movement-recognition/pouch2/lab/timings.md

## findings of 2024-12-01: debugging with gdb and "freertos"-addon
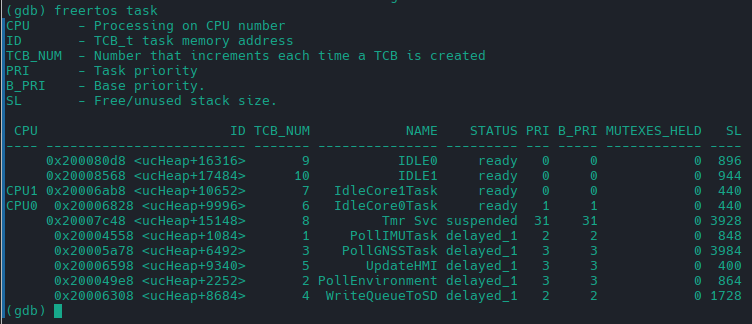
[picture p2: lab/asset/freertos_task_view.png]
Task view


## findings of 2024-11-21: debugging SD-SPI0:
SPI behaves weirdly with `pico_fatfs`-library.
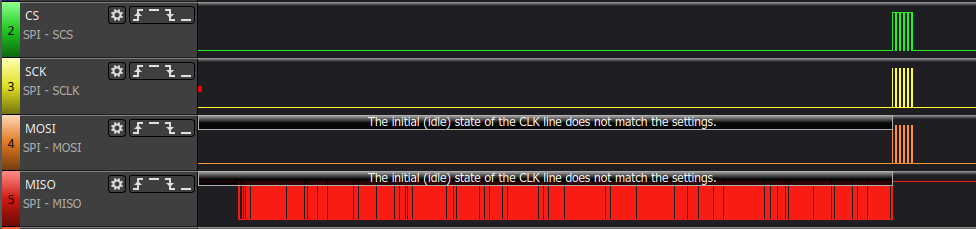
[picture p3: lab/asset/spi_weird_behaviour.png]
weird behaviour


=> solved by resoldering

## findings of 2024-11-13
- 10kHz freeRTOS Tick frequency
- 400kHz I²C
#### poll_imu_sensor()

- 534us @ 10kHz tick frequency
- 528us @ 1kHz tick frequency

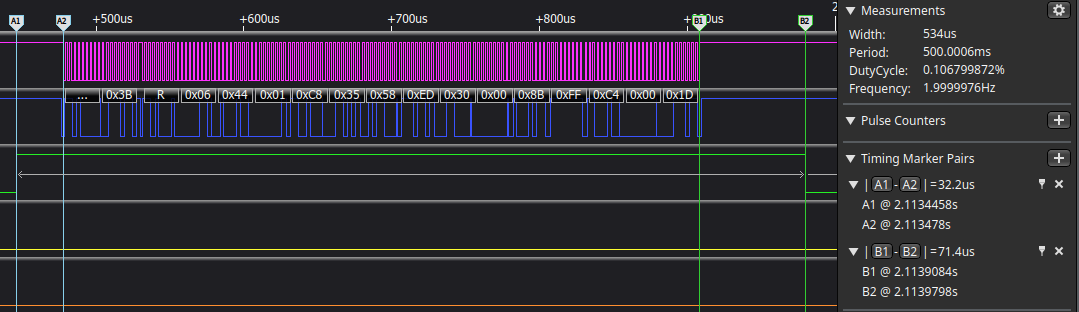
[picture p4: lab/asset/timing_poll_imu_sensor_raw.png]

- channel 0/1 (pink, blue)= I²C bus
- channel 2 (green) = GPIO 22

#### poll_env_sensor()
- 8.6ms @ 10kHz tick frequency
- 3.0ms @ 1kHz tick frequency
I²C-part takes the smallest amount of time, calculations afterwards take multiple milliseconds (!)
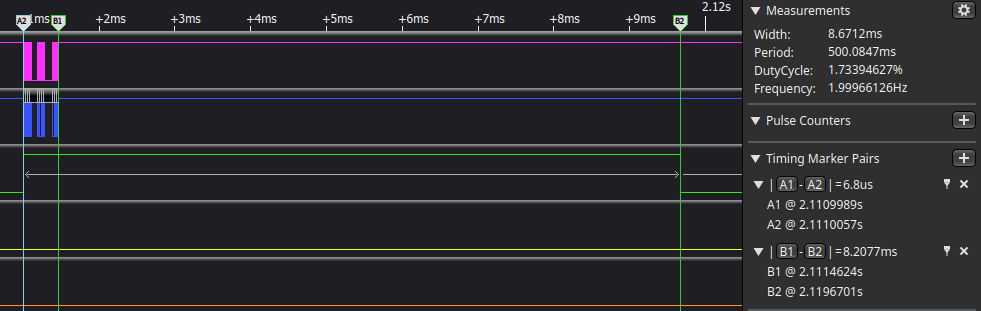
[picture p5: lab/asset/timing_poll_env_sensor_raw.png]

- channel 0/1 (pink, blue)= I²C bus
- channel 2 (green) = GPIO 22
