movement-recognition/pouch2/pcb/assets/pi3_gpio_header.png

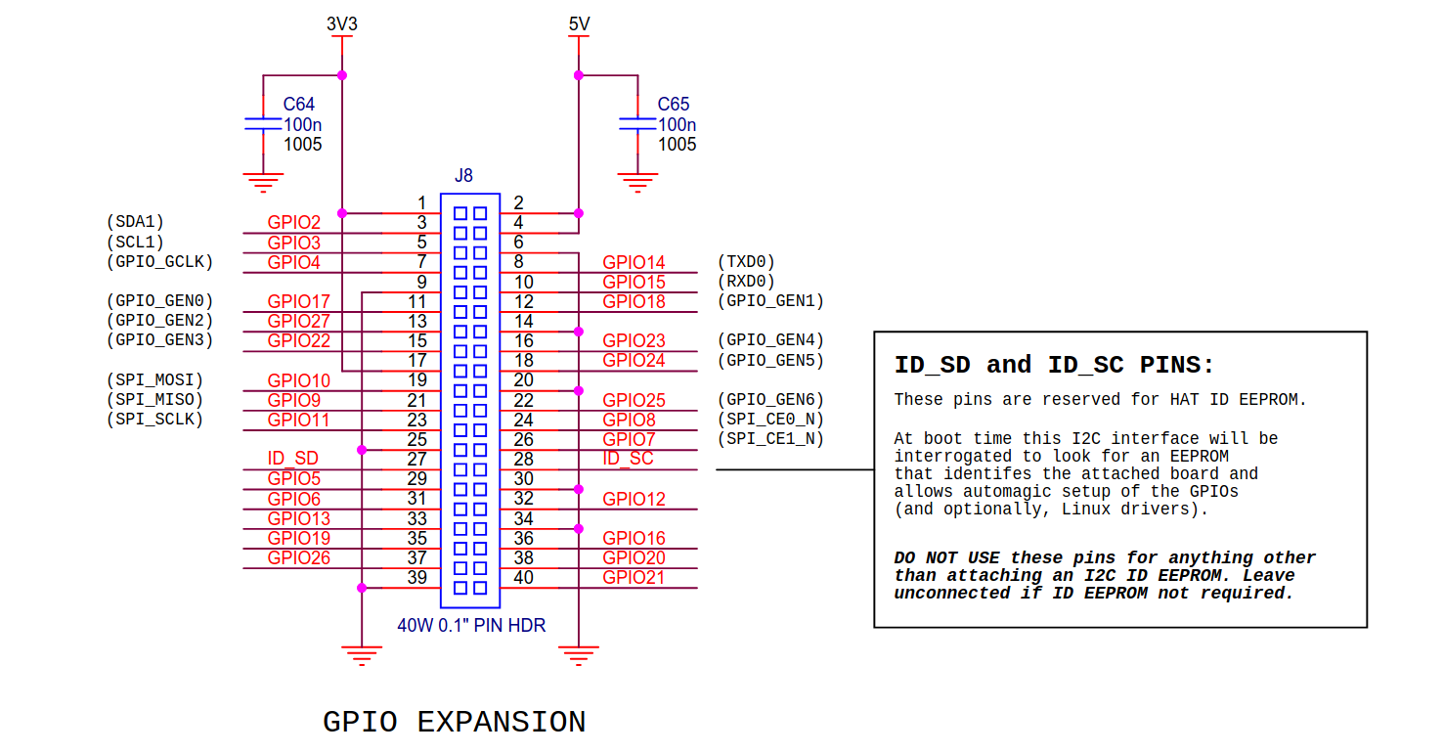
pcb/assets/pi3_gpio_header.png
