movement-recognition/pouch2/pcb/assets/picow-pinout.png

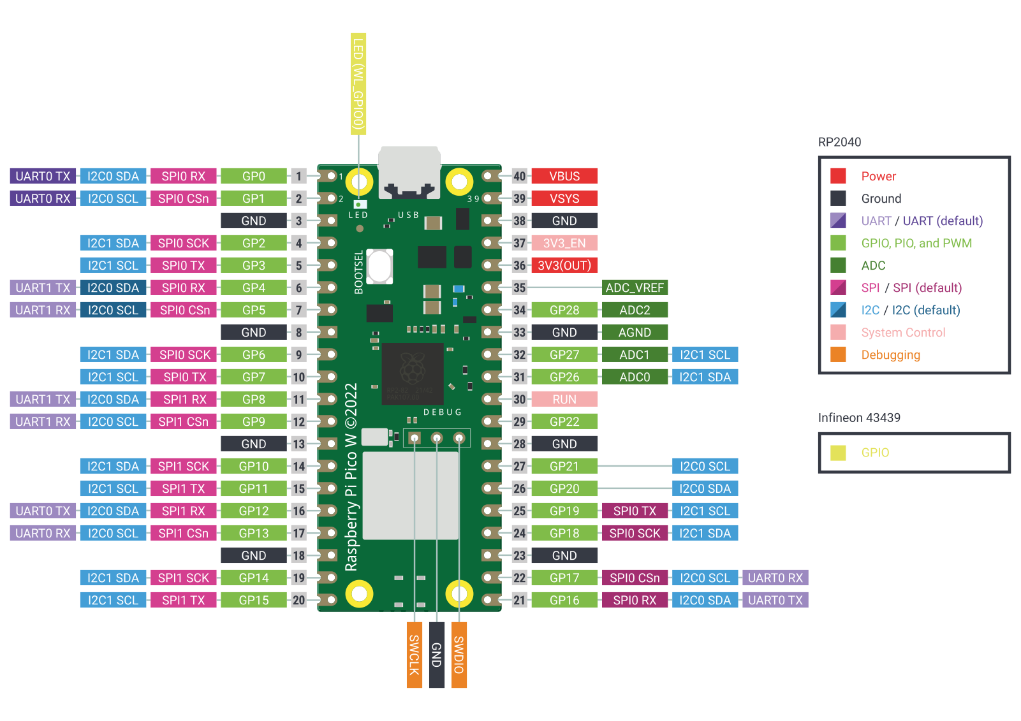
pcb/assets/picow-pinout.png
