movement-recognition/pouch2/pcb/pouch2.kicad_pcb

## KiCad design pcb/pouch2.kicad_pcb (2024-11-26)

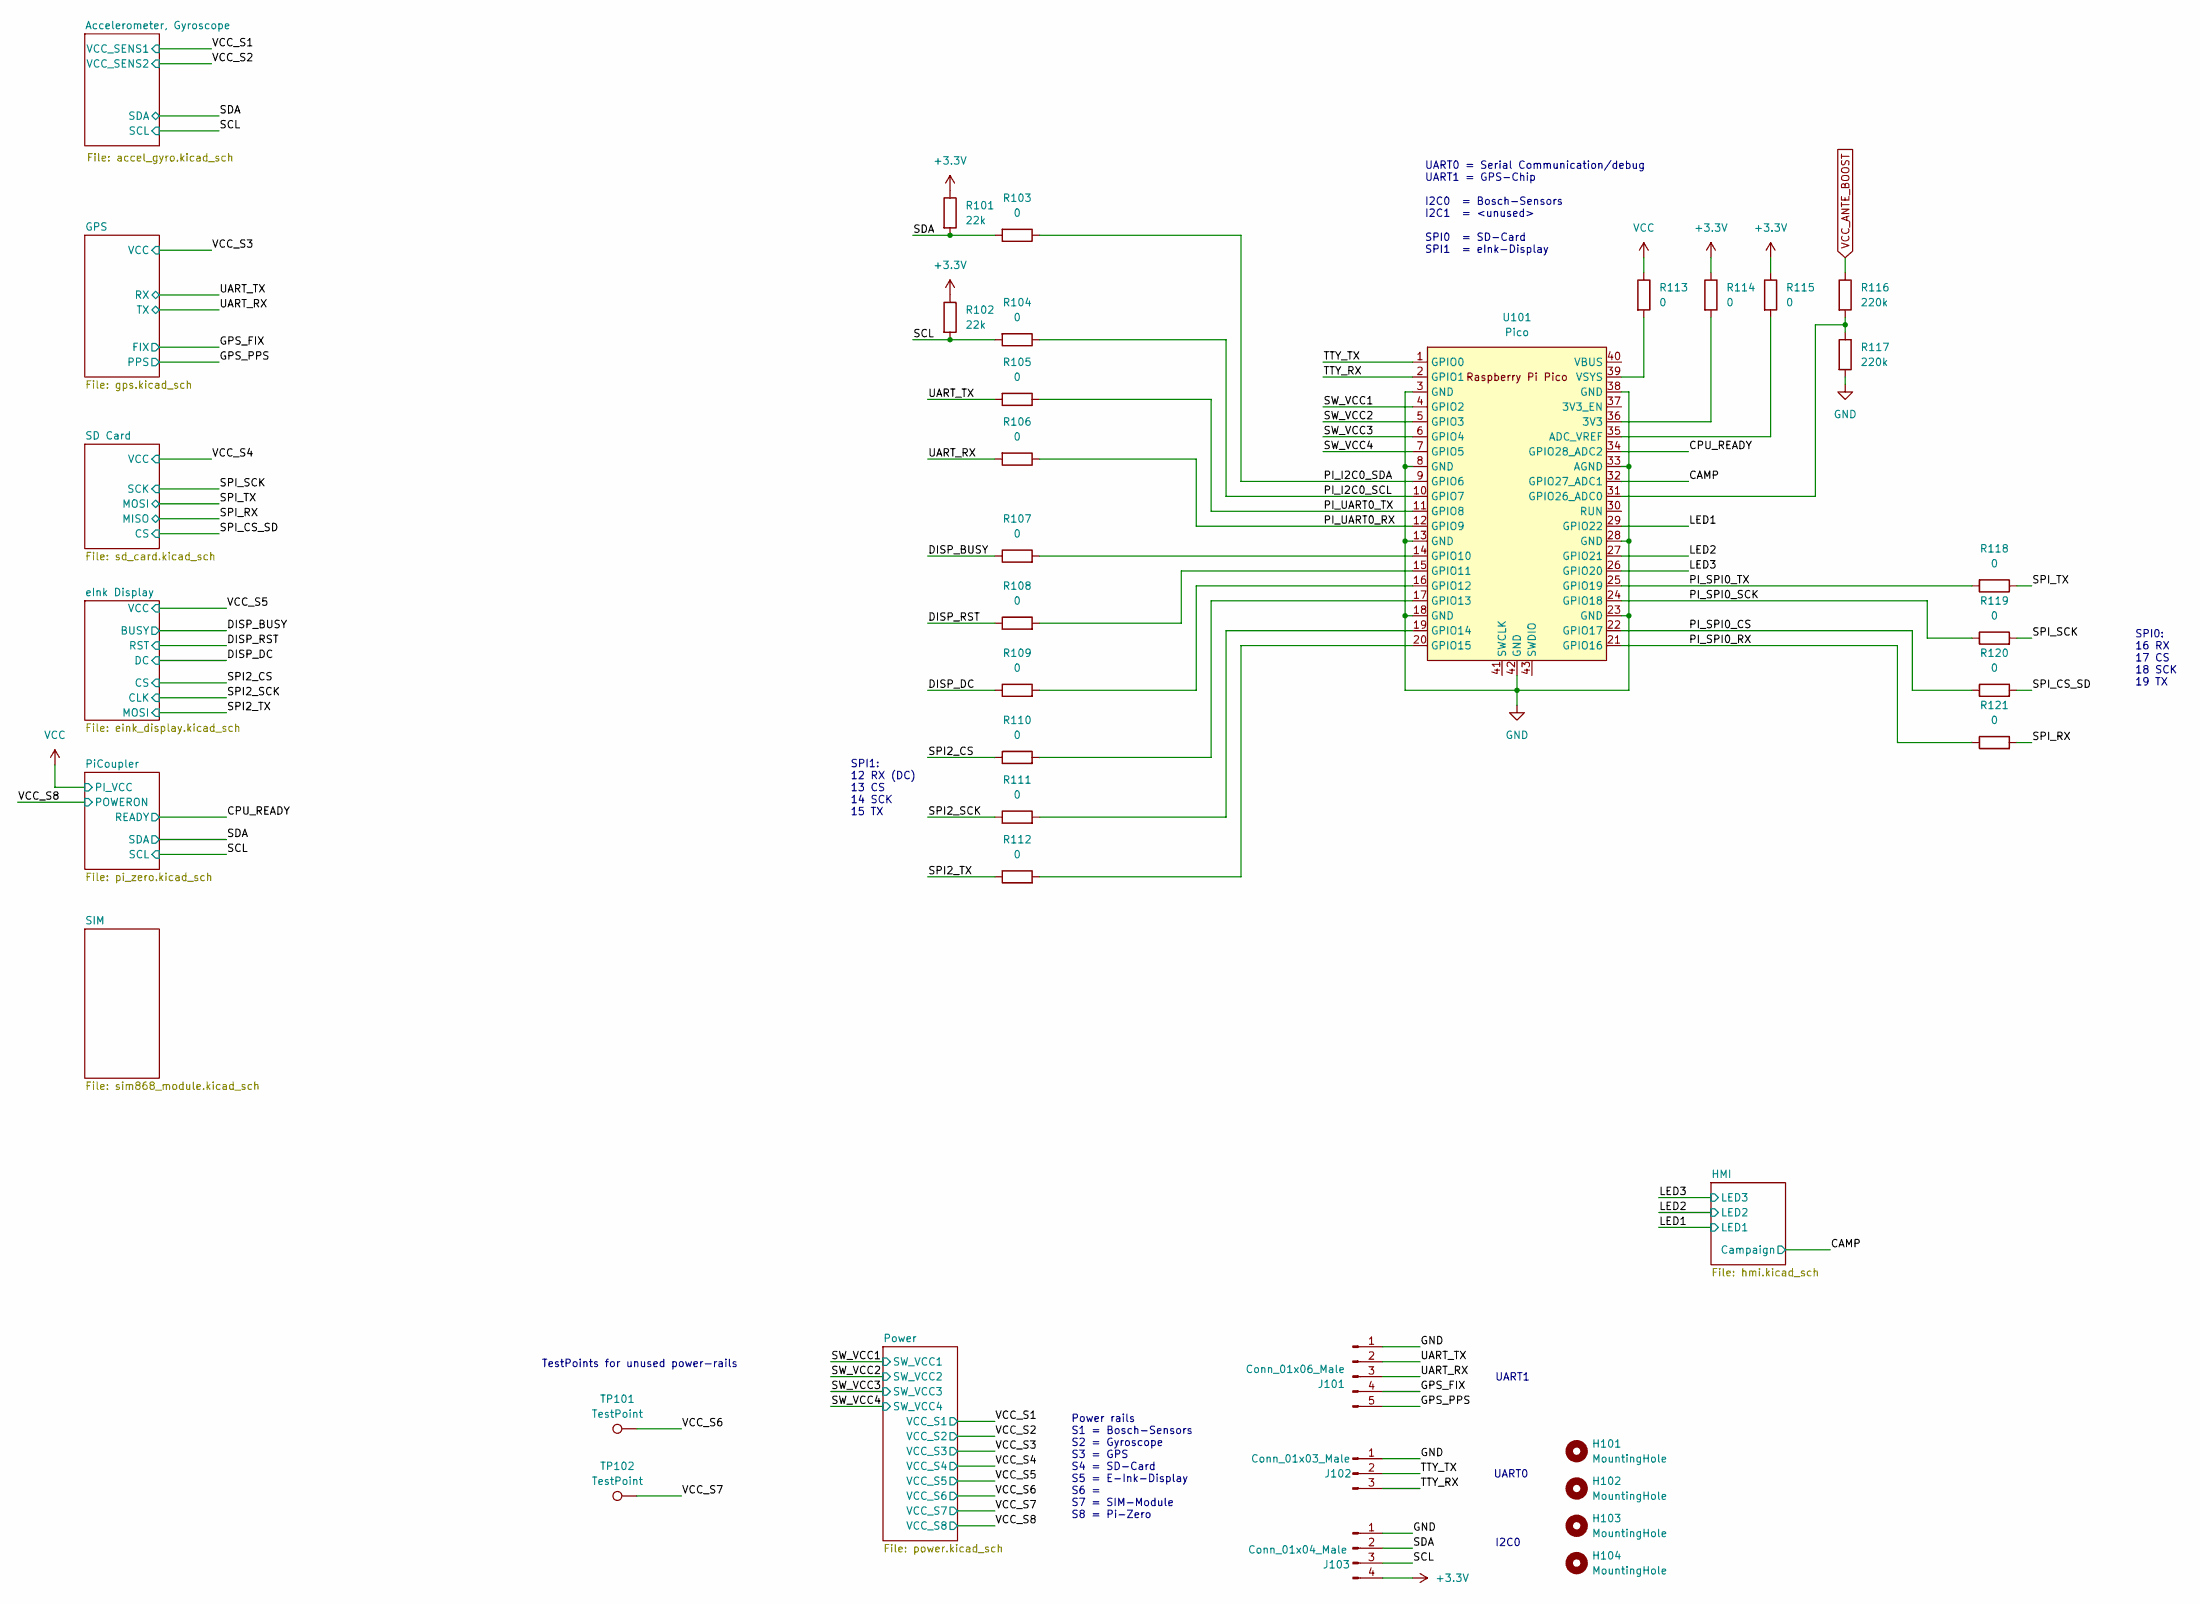
[picture p8: schematic pouch2.kicad_sch, Pouch 2]

Parts:
H101, H102, H103, H104: MountingHole; MountingHole_3.2mm_M3_DIN965_Pad_TopBottom
J101: Conn_01x06_Male; PinHeader_1x05_P2.54mm_Vertical
J102: Conn_01x03_Male; PinHeader_1x03_P2.54mm_Vertical
J103: Conn_01x04_Male; PinHeader_1x04_P2.54mm_Vertical
R101, R102: 22k; R_0805_2012Metric; MPN_Eurocircuit GPR080522K; LCSC C17560
R103, R104, R105, R106, R107, R108, R109, R110, R111, R112, R113, R114, R115, R118, R119, R120, R121: 0; R_0805_2012Metric; MPN_Eurocircuit GPR08050R; LCSC C17477
R116, R117: 220k; R_0805_2012Metric; MPN_Eurocircuit GPR0805220K; LCSC C17556
TP101, TP102: TestPoint; TestPoint_Pad_1.0x1.0mm
U101: Pico; RPi_Pico_SMD_TH

Connections:
+3.3V: J103.4, R101.1, R102.1, R114.1, R115.1; also elsewhere on the board
/CAMP: U101.32 (GPIO27_ADC1); also elsewhere on the board
/CPU_READY: U101.34 (GPIO28_ADC2); also elsewhere on the board
/DISP_BUSY: R107.1; also elsewhere on the board
/DISP_DC: R109.1; also elsewhere on the board
/DISP_RST: R108.1; also elsewhere on the board
/GPS_FIX: J101.4; also elsewhere on the board
/GPS_PPS: J101.5; also elsewhere on the board
/LED1: U101.29 (GPIO22); also elsewhere on the board
/LED2: U101.27 (GPIO21); also elsewhere on the board
/LED3: U101.26 (GPIO20); also elsewhere on the board
/PI_I2C0_SCL: R104.1, U101.10 (GPIO7)
/PI_I2C0_SDA: R103.1, U101.9 (GPIO6)
/PI_SPI0_CS: R120.1, U101.22 (GPIO17)
/PI_SPI0_RX: R121.1, U101.21 (GPIO16)
/PI_SPI0_SCK: R119.1, U101.24 (GPIO18)
/PI_SPI0_TX: R118.2, U101.25 (GPIO19)
/PI_UART0_RX: R106.1, U101.12 (GPIO9)
/PI_UART0_TX: R105.1, U101.11 (GPIO8)
/SCL: J103.3, R102.2, R104.2; also elsewhere on the board
/SDA: J103.2, R101.2, R103.2; also elsewhere on the board
/SPI2_CS: R110.1; also elsewhere on the board
/SPI2_SCK: R111.1; also elsewhere on the board
/SPI2_TX: R112.1; also elsewhere on the board
/SPI_CS_SD: R120.2; also elsewhere on the board
/SPI_RX: R121.2; also elsewhere on the board
/SPI_SCK: R119.2; also elsewhere on the board
/SPI_TX: R118.1; also elsewhere on the board
/SW_VCC1: U101.4 (GPIO2); also elsewhere on the board
/SW_VCC2: U101.5 (GPIO3); also elsewhere on the board
/SW_VCC3: U101.6 (GPIO4); also elsewhere on the board
/SW_VCC4: U101.7 (GPIO5); also elsewhere on the board
/TTY_RX: J102.3, U101.2 (GPIO1)
/TTY_TX: J102.2, U101.1 (GPIO0)
/UART_RX: J101.3, R106.2; also elsewhere on the board
/UART_TX: J101.2, R105.2; also elsewhere on the board
/VCC_S6: TP101.1; also elsewhere on the board
/VCC_S7: TP102.1; also elsewhere on the board
GND: J101.1, J102.1, J103.1, R117.2, U101.3 (GND), U101.8 (GND), U101.13 (GND), U101.18 (GND), U101.23 (GND), U101.28 (GND), U101.33 (AGND), U101.38 (GND), U101.42 (GND); also elsewhere on the board
unnamed: R114.2, U101.36 (3V3)
unnamed: R115.2, U101.35 (ADC_VREF)
unnamed: R107.2, U101.14 (GPIO10)
unnamed: R108.2, U101.15 (GPIO11)
unnamed: R109.2, U101.16 (GPIO12)
unnamed: R110.2, U101.17 (GPIO13)
unnamed: R111.2, U101.19 (GPIO14)
unnamed: R112.2, U101.20 (GPIO15)
unnamed: R116.2, R117.1, U101.31 (GPIO26_ADC0)
unnamed: R113.2, U101.39 (VSYS)
VCC: R113.1; also elsewhere on the board
VCC_ANTE_BOOST: R116.1; also elsewhere on the board

Notes on the sheet:
UART1
Power rails S1 = Bosch-Sensors S2 = Gyroscope S3 = GPS S4 = SD-Card S5 = E-Ink-Display S6 = S7 = SIM-Module S8 = Pi-Zero
UART0
SPI0: 16 RX 17 CS 18 SCK 19 TX
TestPoints for unused power-rails
SPI1: 12 RX (DC) 13 CS 14 SCK 15 TX
I2C0
UART0 = Serial Communication/debug UART1 = GPS-Chip I2C0 = Bosch-Sensors I2C1 = <unused> SPI0 = SD-Card SPI1 = eInk-Display

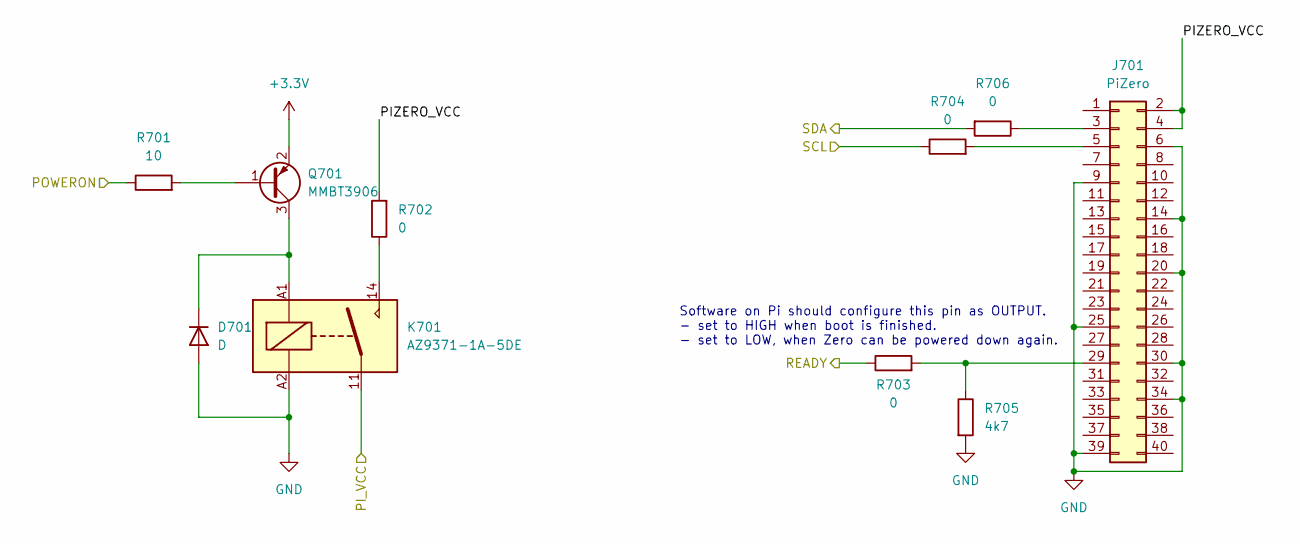
[picture p9: schematic pi_zero.kicad_sch, Pouch 2]

Parts:
D701: D; D_0805_2012Metric
J701: PiZero; Raspberry_Pi_Zero_Socket_wo_drills
K701: AZ9371-1A-5DE; Relay_1-Form-A_Schrack-RYII_RM5mm
Q701: MMBT3906; SOT-23; MPN_Eurocircuit MMBT3906
R701: 10; R_0805_2012Metric; MPN_Eurocircuit GPR080510R; LCSC C17415
R702, R703, R704, R706: 0; R_0805_2012Metric; MPN_Eurocircuit GPR08050R; LCSC C17477
R705: 4k7; R_0805_2012Metric; MPN_Eurocircuit GPR08054K7; LCSC C17673

Connections:
+3.3V: Q701.2 (E); also elsewhere on the board
/CPU_READY: R703.1; also elsewhere on the board
/PiCoupler/PIZERO_VCC: J701.2, J701.4, R702.2
/SCL: R704.1; also elsewhere on the board
/SDA: R706.2; also elsewhere on the board
/VCC_S8: R701.1; also elsewhere on the board
GND: D701.2 (A), J701.6, J701.9, J701.14, J701.20, J701.25, J701.30, J701.34, J701.39, K701.A2, R705.2; also elsewhere on the board
unnamed: D701.1 (K), K701.A1, Q701.3 (C)
unnamed: J701.3, R706.1
unnamed: J701.5, R704.2
unnamed: J701.29, R703.2, R705.1
unnamed: K701.14, R702.1
unnamed: Q701.1 (B), R701.2
VCC: K701.11; also elsewhere on the board

Notes on the sheet:
Software on Pi should configure this pin as OUTPUT. - set to HIGH when boot is finished. - set to LOW, when Zero can be powered down again.

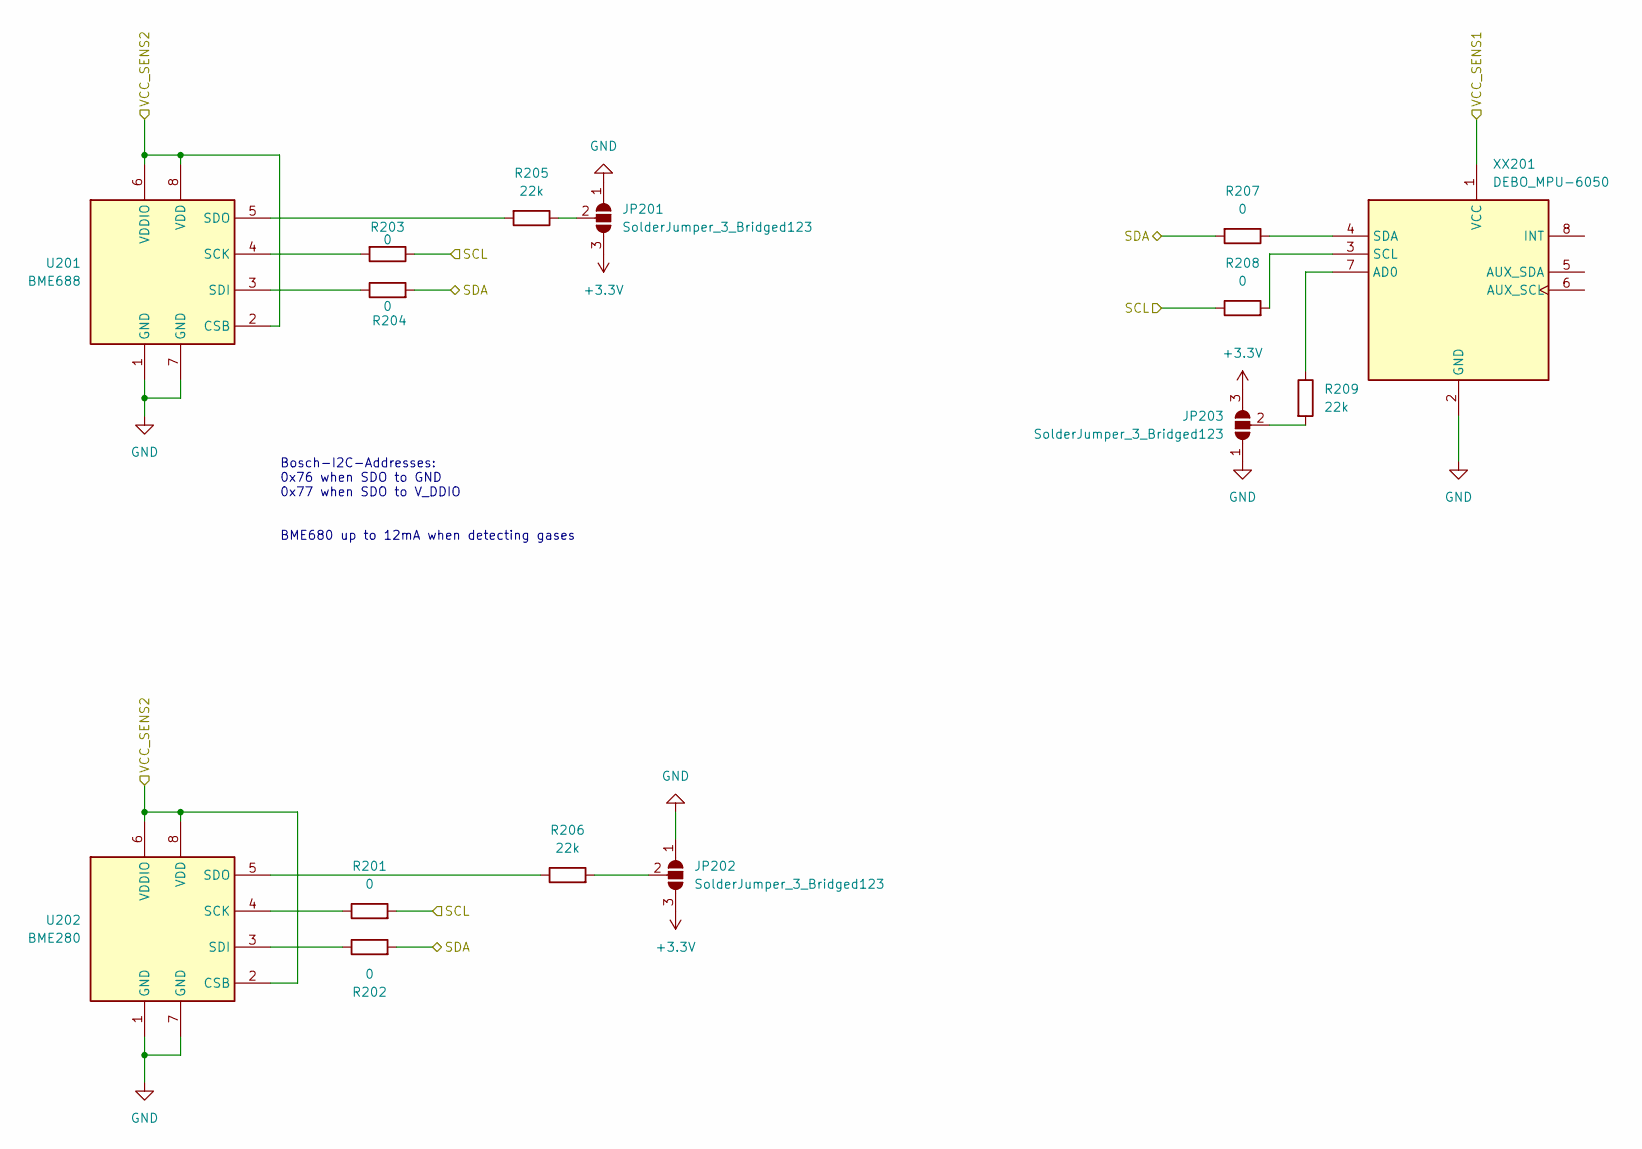
[picture p10: schematic accel_gyro.kicad_sch, Pouch 2]

Parts:
JP201, JP202, JP203: SolderJumper_3_Bridged123; SolderJumper-3_P2.0mm_Open_TrianglePad1.0x1.5mm_NumberLabels
R201, R202, R203, R204, R207, R208: 0; R_0805_2012Metric; MPN_Eurocircuit GPR08050R; LCSC C17477
R205, R206, R209: 22k; R_0805_2012Metric; MPN_Eurocircuit GPR080522K; LCSC C17560
U201: BME688; Bosch_LGA-8_3x3mm_P0.8mm_ClockwisePinNumbering
U202: BME280; Bosch_LGA-8_2.5x2.5mm_P0.65mm_ClockwisePinNumbering
XX201: DEBO_MPU-6050; DEBO_MPU6050

Connections:
+3.3V: JP201.3 (B), JP202.3 (B), JP203.3 (B); also elsewhere on the board
/SCL: R201.2, R203.1, R208.1; also elsewhere on the board
/SDA: R202.2, R204.2, R207.2; also elsewhere on the board
/VCC_S1: XX201.1 (VCC); also elsewhere on the board
/VCC_S2: U201.2 (CSB), U201.6 (VDDIO), U201.8 (VDD), U202.2 (CSB), U202.6 (VDDIO), U202.8 (VDD); also elsewhere on the board
GND: JP201.1 (A), JP202.1 (A), JP203.1 (A), U201.1 (GND), U201.7 (GND), U202.1 (GND), U202.7 (GND), XX201.2 (GND); also elsewhere on the board
unnamed: JP201.2 (C), R205.1
unnamed: JP202.2 (C), R206.2
unnamed: JP203.2 (C), R209.2
unnamed: R203.2, U201.4 (SCK)
unnamed: R204.1, U201.3 (SDI)
unnamed: R205.2, U201.5 (SDO)
unnamed: R201.1, U202.4 (SCK)
unnamed: R202.1, U202.3 (SDI)
unnamed: R206.1, U202.5 (SDO)
unnamed: R209.1, XX201.7 (AD0)
unnamed: R208.2, XX201.3 (SCL)
unnamed: R207.1, XX201.4 (SDA)

Notes on the sheet:
Bosch-I2C-Addresses: 0x76 when SDO to GND 0x77 when SDO to V_DDIO BME680 up to 12mA when detecting gases

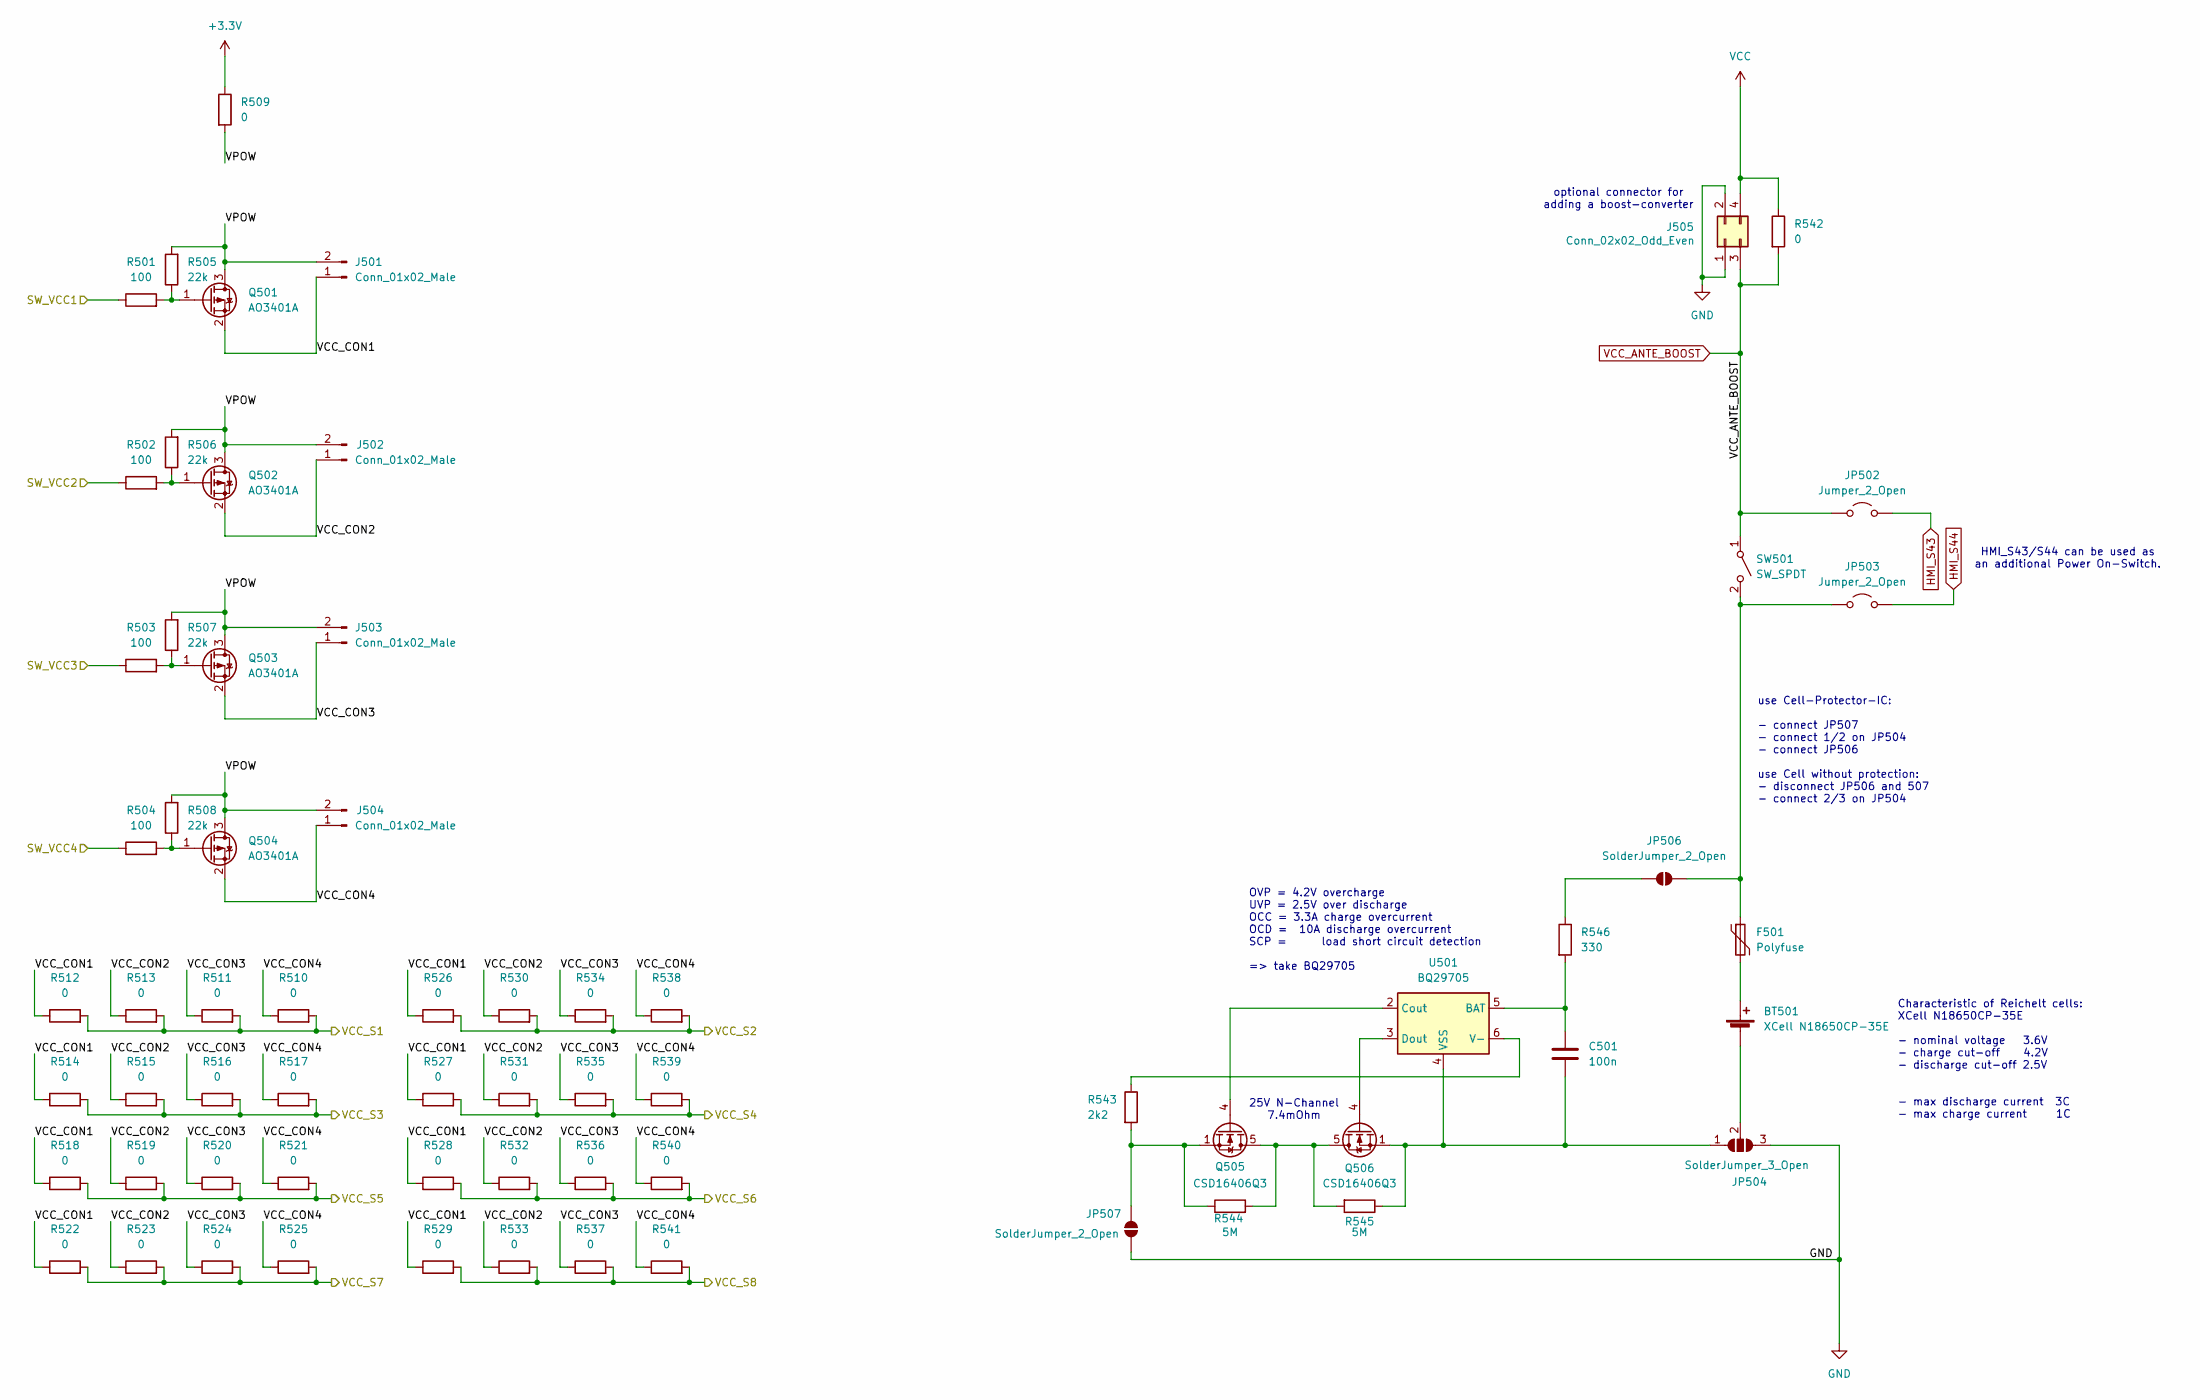
[picture p11: schematic power.kicad_sch, Pouch 2]

Parts:
BT501: XCell N18650CP-35E; 18650_Keystone_1043
C501: 100n; C_0805_2012Metric; MPN_Eurocircuit GPC0805104
F501: Polyfuse; Fuse_BelFuse_0ZRE0005FF_L8.3mm_W3.8mm
J501, J502, J503, J504: Conn_01x02_Male; PinHeader_1x02_P2.54mm_Vertical
J505: Conn_02x02_Odd_Even; PinHeader_1x04_P2.54mm_Vertical
JP502, JP503: Jumper_2_Open; SolderJumper-2_P1.3mm_Open_TrianglePad1.0x1.5mm
JP504: SolderJumper_3_Open; SolderJumper-3_P2.0mm_Open_TrianglePad1.0x1.5mm_NumberLabels
JP506, JP507: SolderJumper_2_Open; SolderJumper-2_P1.3mm_Open_TrianglePad1.0x1.5mm
Q501, Q502, Q503, Q504: AO3401A; SOT-23; MPN_Eurocircuit AO3401A; LCSC C15127
Q505, Q506: CSD16406Q3; VSON-8-1EP_3x3mm_P0.65mm_EP1.65x2.4mm; MPN_Eurocircuit CSD16406Q3
R501, R502, R503, R504: 100; R_0805_2012Metric; MPN_Eurocircuit GPR0805100R; LCSC C17408
R505, R506, R507, R508: 22k; R_0805_2012Metric; MPN_Eurocircuit GPR080522K; LCSC C17560
R509, R510, R511, R512, R513, R514, R515, R516, R517, R518, R519, R520, R521, R522, R523, R524, R525, R526, R527, R528, R529, R530, R531, R532, R533, R534, R535, R536, R537, R538, R539, R540, R541, R542: 0; R_0805_2012Metric; MPN_Eurocircuit GPR08050R; LCSC C17477
R543: 2k2; R_0805_2012Metric; MPN_Eurocircuit GPR08052K2; LCSC C17520
R544, R545: 5M; R_0805_2012Metric; MPN_Eurocircuit GPR08055M1; LCSC C2933370
R546: 330; R_0805_2012Metric; MPN_Eurocircuit GPR0805330R; LCSC C17630
SW501: SW_SPDT; PinHeader_1x02_P2.54mm_Vertical
U501: BQ29705; WSON-6_1.5x1.5mm_P0.5mm; MPN_Eurocircuit BQ29705DSER

Connections:
+3.3V: R509.1; also elsewhere on the board
/Power/VCC_CON1: J501.1, Q501.2 (S), R512.1, R514.1, R518.1, R522.1, R526.1, R527.1, R528.1, R529.1
/Power/VCC_CON2: J502.1, Q502.2 (S), R513.1, R515.1, R519.1, R523.1, R530.1, R531.1, R532.1, R533.1
/Power/VCC_CON3: J503.1, Q503.2 (S), R511.1, R516.1, R520.1, R524.1, R534.1, R535.1, R536.1, R537.1
/Power/VCC_CON4: J504.1, Q504.2 (S), R510.1, R517.1, R521.1, R525.1, R538.1, R539.1, R540.1, R541.1
/Power/VPOW: J501.2, J502.2, J503.2, J504.2, Q501.3 (D), Q502.3 (D), Q503.3 (D), Q504.3 (D), R505.2, R506.2, R507.2, R508.2, R509.2
/SW_VCC1: R501.1; also elsewhere on the board
/SW_VCC2: R502.1; also elsewhere on the board
/SW_VCC3: R503.1; also elsewhere on the board
/SW_VCC4: R504.1; also elsewhere on the board
/VCC_S1: R510.2, R511.2, R512.2, R513.2; also elsewhere on the board
/VCC_S2: R526.2, R530.2, R534.2, R538.2; also elsewhere on the board
/VCC_S3: R514.2, R515.2, R516.2, R517.2; also elsewhere on the board
/VCC_S4: R527.2, R531.2, R535.2, R539.2; also elsewhere on the board
/VCC_S5: R518.2, R519.2, R520.2, R521.2; also elsewhere on the board
/VCC_S6: R528.2, R532.2, R536.2, R540.2; also elsewhere on the board
/VCC_S7: R522.2, R523.2, R524.2, R525.2; also elsewhere on the board
/VCC_S8: R529.2, R533.2, R537.2, R541.2; also elsewhere on the board
GND: J505.1, J505.2, JP504.3 (B), JP507.1 (A); also elsewhere on the board
HMI_S43: JP502.2 (B); also elsewhere on the board
HMI_S44: JP503.2 (B); also elsewhere on the board
unnamed: BT501.1 (+), F501.2
unnamed: BT501.2 (-), JP504.2 (C)
unnamed: F501.1, JP503.1 (A), JP506.1 (A), SW501.2 (B)
unnamed: C501.2, JP504.1 (A), Q506.1 (S), Q506.2 (S), Q506.3 (S), R545.1, U501.4 (VSS)
unnamed: JP506.2 (B), R546.1
unnamed: JP507.2 (B), Q505.1 (S), Q505.2 (S), Q505.3 (S), R543.2, R544.1
unnamed: Q501.1 (G), R501.2, R505.1
unnamed: Q502.1 (G), R502.2, R506.1
unnamed: Q503.1 (G), R503.2, R507.1
unnamed: Q504.1 (G), R504.2, R508.1
unnamed: Q505.5 (D), Q506.5 (D), R544.2, R545.2
unnamed: Q505.4 (G), U501.2 (Cout)
unnamed: Q506.4 (G), U501.3 (Dout)
unnamed: C501.1, R546.2, U501.5 (BAT)
unnamed: R543.1, U501.6 (V-)
VCC: J505.4, R542.1; also elsewhere on the board
VCC_ANTE_BOOST: J505.3, JP502.1 (A), R542.2, SW501.1 (A); also elsewhere on the board

Notes on the sheet:
25V N-Channel 7.4mOhm
HMI_S43/S44 can be used as an additional Power On-Switch.
OVP = 4.2V overcharge UVP = 2.5V over discharge OCC = 3.3A charge overcurrent OCD = 10A discharge overcurrent SCP = load short circuit detection => take BQ29705
use Cell-Protector-IC: - connect JP507 - connect 1/2 on JP504 - connect JP506 use Cell without protection: - disconnect JP506 and 507 - connect 2/3 on JP504
optional connector for adding a boost-converter
Characteristic of Reichelt cells: XCell N18650CP-35E - nominal voltage 3.6V - charge cut-off 4.2V - discharge cut-off 2.5V - max discharge current 3C - max charge current 1C

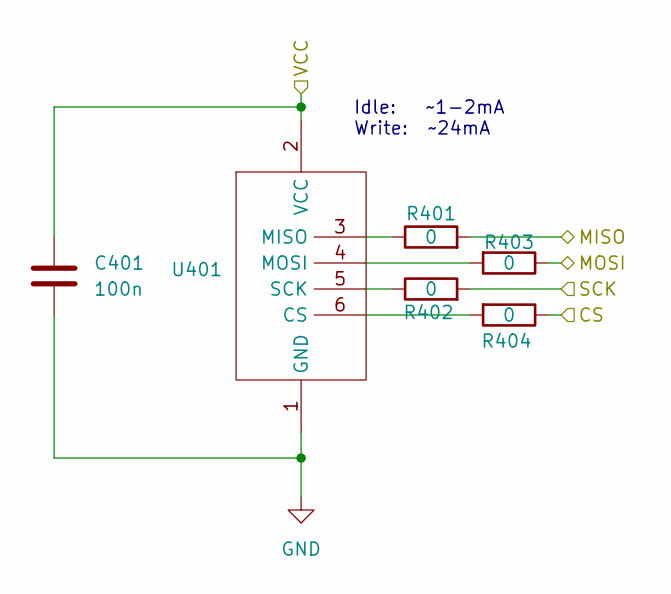
[picture p12: schematic sd_card.kicad_sch, Pouch 2]

Parts:
C401: 100n; C_0805_2012Metric
R401, R402, R403, R404: 0; R_0805_2012Metric; MPN_Eurocircuit GPR08050R; LCSC C17477
U401: DEBO_SD-Card

Connections:
/SPI_CS_SD: R404.1; also elsewhere on the board
/SPI_RX: R401.2; also elsewhere on the board
/SPI_SCK: R402.2; also elsewhere on the board
/SPI_TX: R403.1; also elsewhere on the board
/VCC_S4: C401.1, U401.2 (VCC); also elsewhere on the board
GND: C401.2, U401.1 (GND); also elsewhere on the board
unnamed: R404.2, U401.6 (CS)
unnamed: R401.1, U401.3 (MISO)
unnamed: R403.2, U401.4 (MOSI)
unnamed: R402.1, U401.5 (SCK)

Notes on the sheet:
Idle: ~1-2mA Write: ~24mA

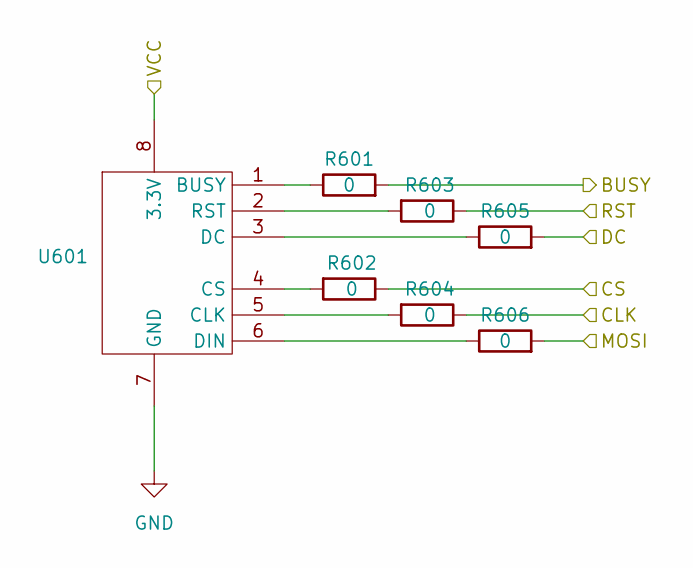
[picture p13: schematic eink_display.kicad_sch, Pouch 2]

Parts:
R601, R602, R603, R604, R605, R606: 0; R_0805_2012Metric; MPN_Eurocircuit GPR08050R; LCSC C17477
U601: PinHeader_1x08_P2.54mm_Vertical

Connections:
/DISP_BUSY: R601.2; also elsewhere on the board
/DISP_DC: R605.2; also elsewhere on the board
/DISP_RST: R603.1; also elsewhere on the board
/SPI2_CS: R602.1; also elsewhere on the board
/SPI2_SCK: R604.1; also elsewhere on the board
/SPI2_TX: R606.2; also elsewhere on the board
/VCC_S5: U601.8 (3.3V); also elsewhere on the board
GND: U601.7 (GND); also elsewhere on the board
unnamed: R601.1, U601.1 (BUSY)
unnamed: R604.2, U601.5 (CLK)
unnamed: R602.2, U601.4 (CS)
unnamed: R605.1, U601.3 (DC)
unnamed: R606.1, U601.6 (DIN)
unnamed: R603.2, U601.2 (RST)

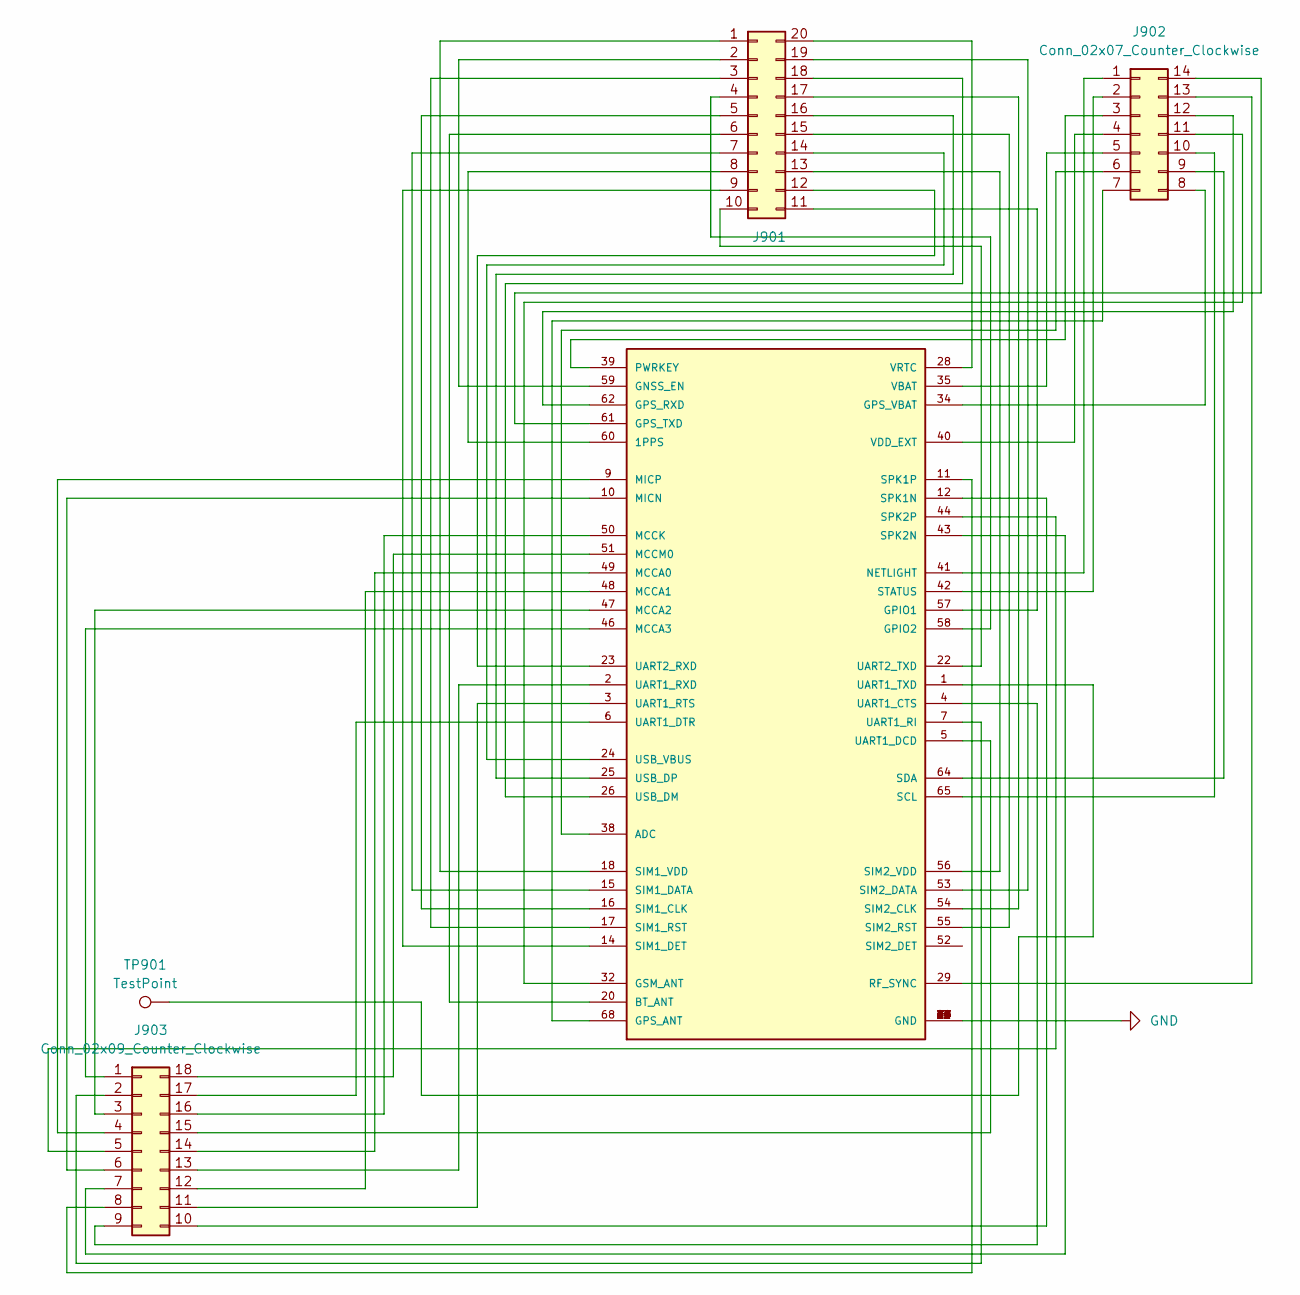
[picture p14: schematic sim868_module.kicad_sch, Pouch 2]

Parts:
J901: Conn_02x03_Counter_Clockwise; PinHeader_2x10_P1.00mm_Vertical_SMD
J902: Conn_02x07_Counter_Clockwise; PinHeader_2x07_P1.00mm_Vertical_SMD
J903: Conn_02x09_Counter_Clockwise; PinHeader_2x09_P1.00mm_Vertical_SMD
TP901: TestPoint; TestPoint_Pad_D1.0mm
U901: SIM868; XCVR_SIM868

Connections:
GND: U901.8 (GND), U901.13 (GND), U901.19 (GND), U901.21 (GND), U901.27 (GND), U901.30 (GND), U901.31 (GND), U901.33 (GND), U901.36 (GND), U901.37 (GND), U901.45 (GND), U901.63 (GND), U901.66 (GND), U901.67 (GND), U901.69 (GND), U901.70 (GND), U901.71 (GND), U901.72 (GND), U901.73 (GND), U901.74 (GND), U901.75 (GND), U901.76 (GND), U901.77 (GND); also elsewhere on the board
unnamed: J901.1, U901.18 (SIM1_VDD)
unnamed: J901.2, U901.59 (GNSS_EN)
unnamed: J901.3, U901.17 (SIM1_RST)
unnamed: J901.4, U901.58 (GPIO2)
unnamed: J901.5, U901.16 (SIM1_CLK)
unnamed: J901.6, U901.20 (BT_ANT)
unnamed: J901.7, U901.15 (SIM1_DATA)
unnamed: J901.8, U901.60 (1PPS)
unnamed: J901.9, U901.14 (SIM1_DET)
unnamed: J901.10, U901.22 (UART2_TXD)
unnamed: J901.11, U901.57 (GPIO1)
unnamed: J901.12, U901.23 (UART2_RXD)
unnamed: J901.13, U901.56 (SIM2_VDD)
unnamed: J901.14, U901.24 (USB_VBUS)
unnamed: J901.15, U901.55 (SIM2_RST)
unnamed: J901.16, U901.25 (USB_DP)
unnamed: J901.17, U901.54 (SIM2_CLK)
unnamed: J901.18, U901.26 (USB_DM)
unnamed: J901.19, U901.53 (SIM2_DATA)
unnamed: J901.20, U901.28 (VRTC)
unnamed: J902.1, U901.41 (NETLIGHT)
unnamed: J902.2, U901.42 (STATUS)
unnamed: J902.3, U901.39 (PWRKEY)
unnamed: J902.4, U901.40 (VDD_EXT)
unnamed: J902.5, U901.35 (VBAT)
unnamed: J902.6, U901.38 (ADC)
unnamed: J902.7, U901.68 (GPS_ANT)
unnamed: J902.8, U901.34 (GPS_VBAT)
unnamed: J902.9, U901.64 (SDA)
unnamed: J902.10, U901.65 (SCL)
unnamed: J902.11, U901.32 (GSM_ANT)
unnamed: J902.12, U901.62 (GPS_RXD)
unnamed: J902.13, U901.29 (RF_SYNC)
unnamed: J902.14, U901.61 (GPS_TXD)
unnamed: J903.1, U901.46 (MCCA3)
unnamed: J903.2, U901.7 (UART1_RI)
unnamed: J903.3, U901.47 (MCCA2)
unnamed: J903.4, U901.9 (MICP)
unnamed: J903.5, U901.44 (SPK2P)
unnamed: J903.6, U901.10 (MICN)
unnamed: J903.7, U901.43 (SPK2N)
unnamed: J903.8, U901.11 (SPK1P)
unnamed: J903.9, U901.4 (UART1_CTS)
unnamed: J903.10, U901.12 (SPK1N)
unnamed: J903.11, U901.3 (UART1_RTS)
unnamed: J903.12, U901.48 (MCCA1)
unnamed: J903.13, U901.2 (UART1_RXD)
unnamed: J903.14, U901.49 (MCCA0)
unnamed: J903.15, U901.5 (UART1_DCD)
unnamed: J903.16, U901.50 (MCCK)
unnamed: J903.17, U901.6 (UART1_DTR)
unnamed: J903.18, U901.51 (MCCM0)
unnamed: TP901.1, U901.1 (UART1_TXD)

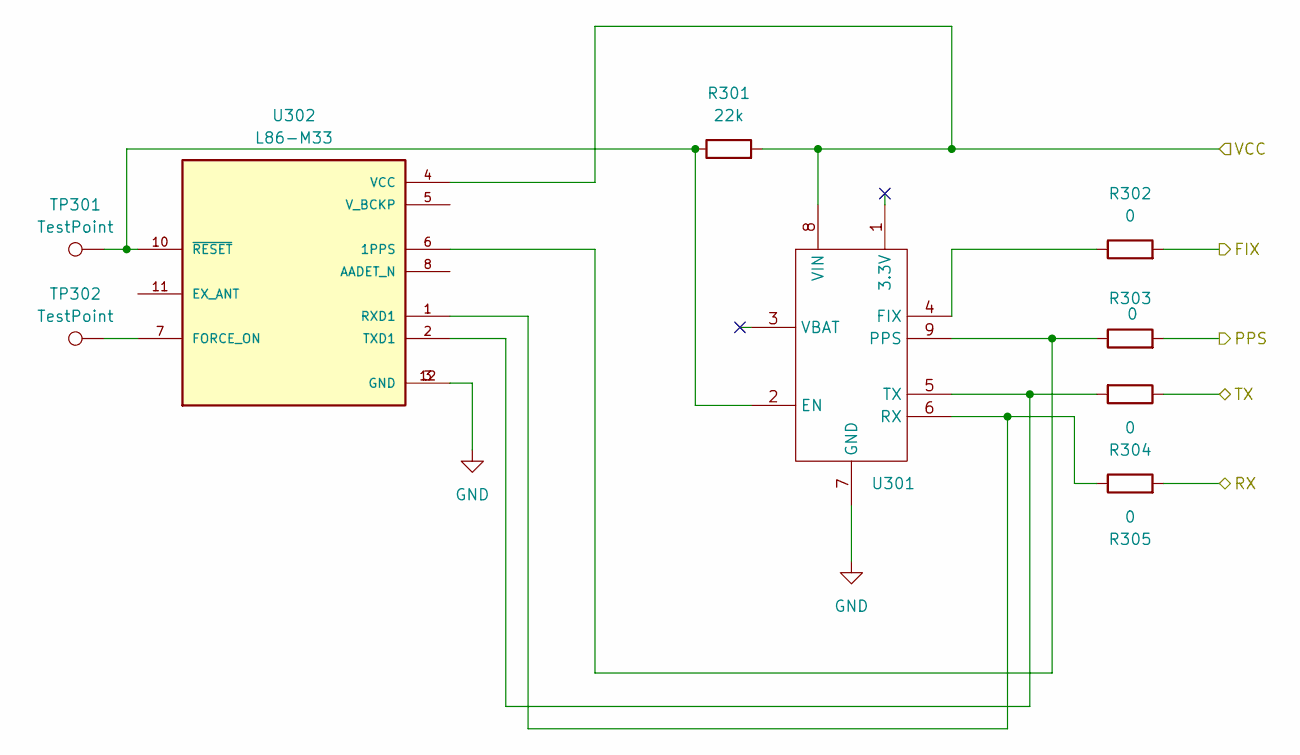
[picture p15: schematic gps.kicad_sch, Pouch 2]

Parts:
R301: 22k; R_0805_2012Metric; MPN_Eurocircuit GPR080522K; LCSC C17560
R302, R303, R304, R305: 0; R_0805_2012Metric; MPN_Eurocircuit GPR08050R; LCSC C17477
TP301, TP302: TestPoint; TestPoint_Pad_1.0x1.0mm
U301: DEBO_GPS
U302: L86-M33; XCVR_L86-M33

Connections:
/GPS_FIX: R302.2; also elsewhere on the board
/GPS_PPS: R303.2; also elsewhere on the board
/UART_RX: R304.1; also elsewhere on the board
/UART_TX: R305.2; also elsewhere on the board
/VCC_S3: R301.2, U301.8 (VIN), U302.4 (VCC); also elsewhere on the board
GND: U301.7 (GND), U302.3 (GND), U302.12 (GND); also elsewhere on the board
unnamed: R301.1, TP301.1, U301.2 (EN), U302.10 (~RESET)
unnamed: R302.1, U301.4 (FIX)
unnamed: R303.1, U301.9 (PPS), U302.6 (1PPS)
unnamed: R305.1, U301.6 (RX), U302.1 (RXD1)
unnamed: R304.2, U301.5 (TX), U302.2 (TXD1)
unnamed: TP302.1, U302.7 (FORCE_ON)
