movement-recognition/pouch2/pcb/pouch2.kicad_pcb

## KiCad design pcb/pouch2.kicad_pcb (continued)

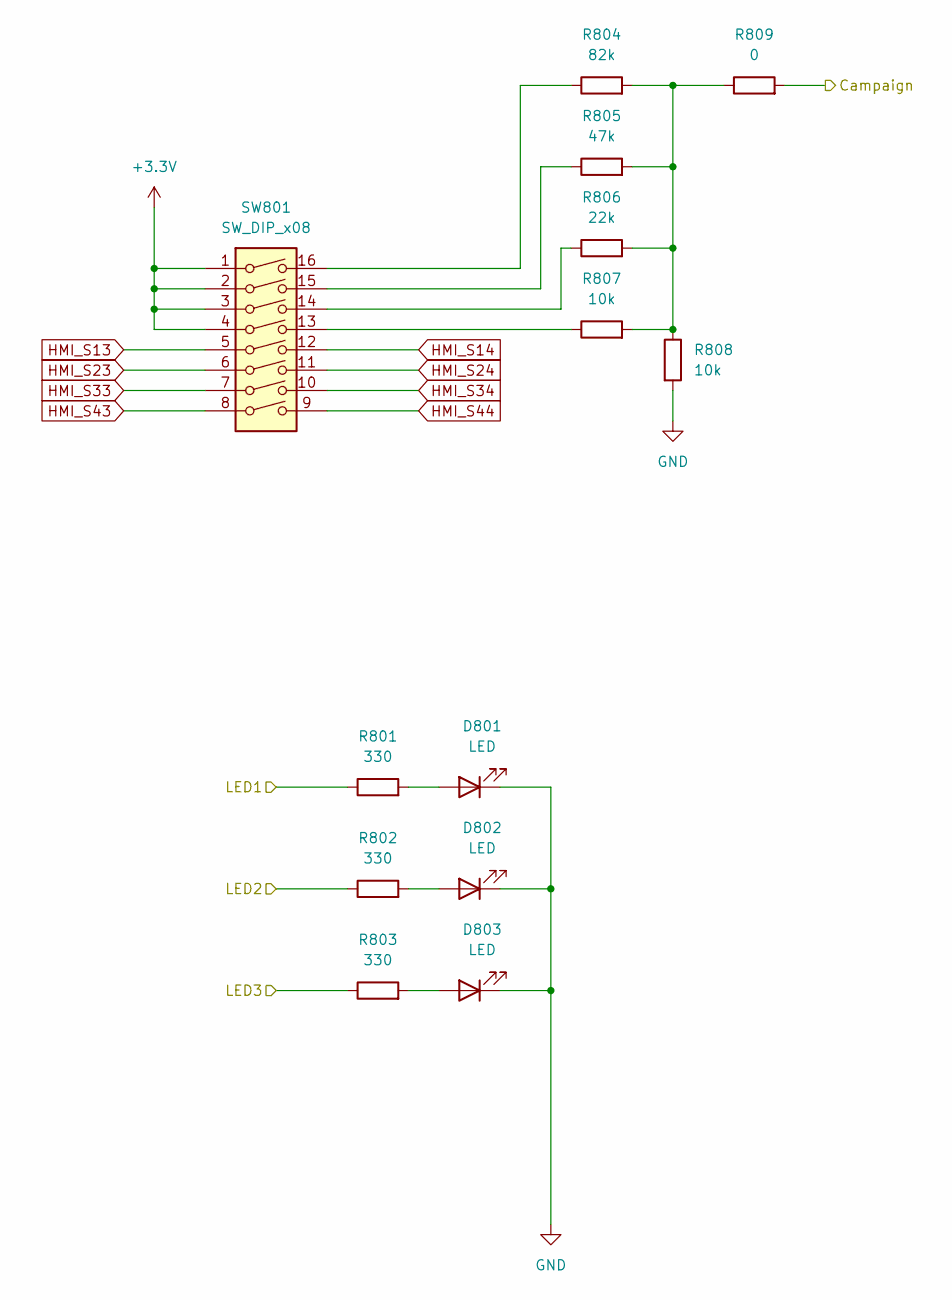
[picture p16: schematic hmi.kicad_sch, Pouch 2]

Parts:
D801, D802, D803: LED; LED_D5.0mm
R801, R802, R803: 330; R_0805_2012Metric; MPN_Eurocircuit GPR0805330R; LCSC C17630
R804: 82k; R_0805_2012Metric; MPN_Eurocircuit GPR080582K; LCSC C17840
R805: 47k; R_0805_2012Metric; MPN_Eurocircuit GPR080547K; LCSC C17713
R806: 22k; R_0805_2012Metric; MPN_Eurocircuit GPR080522K; LCSC C17560
R807, R808: 10k; R_0805_2012Metric; MPN_Eurocircuit GPR080510K; LCSC C17414
R809: 0; R_0805_2012Metric; MPN_Eurocircuit GPR08050R; LCSC C17477
SW801: SW_DIP_x08; SW_DIP_SPSTx08_Slide_9.78x22.5mm_W7.62mm_P2.54mm

Connections:
+3.3V: SW801.1, SW801.2, SW801.3, SW801.4; also elsewhere on the board
/CAMP: R809.2; also elsewhere on the board
/LED1: R801.1; also elsewhere on the board
/LED2: R802.1; also elsewhere on the board
/LED3: R803.1; also elsewhere on the board
GND: D801.1 (K), D802.1 (K), D803.1 (K), R808.2; also elsewhere on the board
HMI_S13: SW801.5
HMI_S14: SW801.12
HMI_S23: SW801.6
HMI_S24: SW801.11
HMI_S33: SW801.7
HMI_S34: SW801.10
HMI_S43: SW801.8; also elsewhere on the board
HMI_S44: SW801.9; also elsewhere on the board
unnamed: D801.2 (A), R801.2
unnamed: D802.2 (A), R802.2
unnamed: D803.2 (A), R803.2
unnamed: R804.1, SW801.16
unnamed: R804.2, R805.2, R806.2, R807.2, R808.1, R809.1
unnamed: R805.1, SW801.15
unnamed: R806.1, SW801.14
unnamed: R807.1, SW801.13

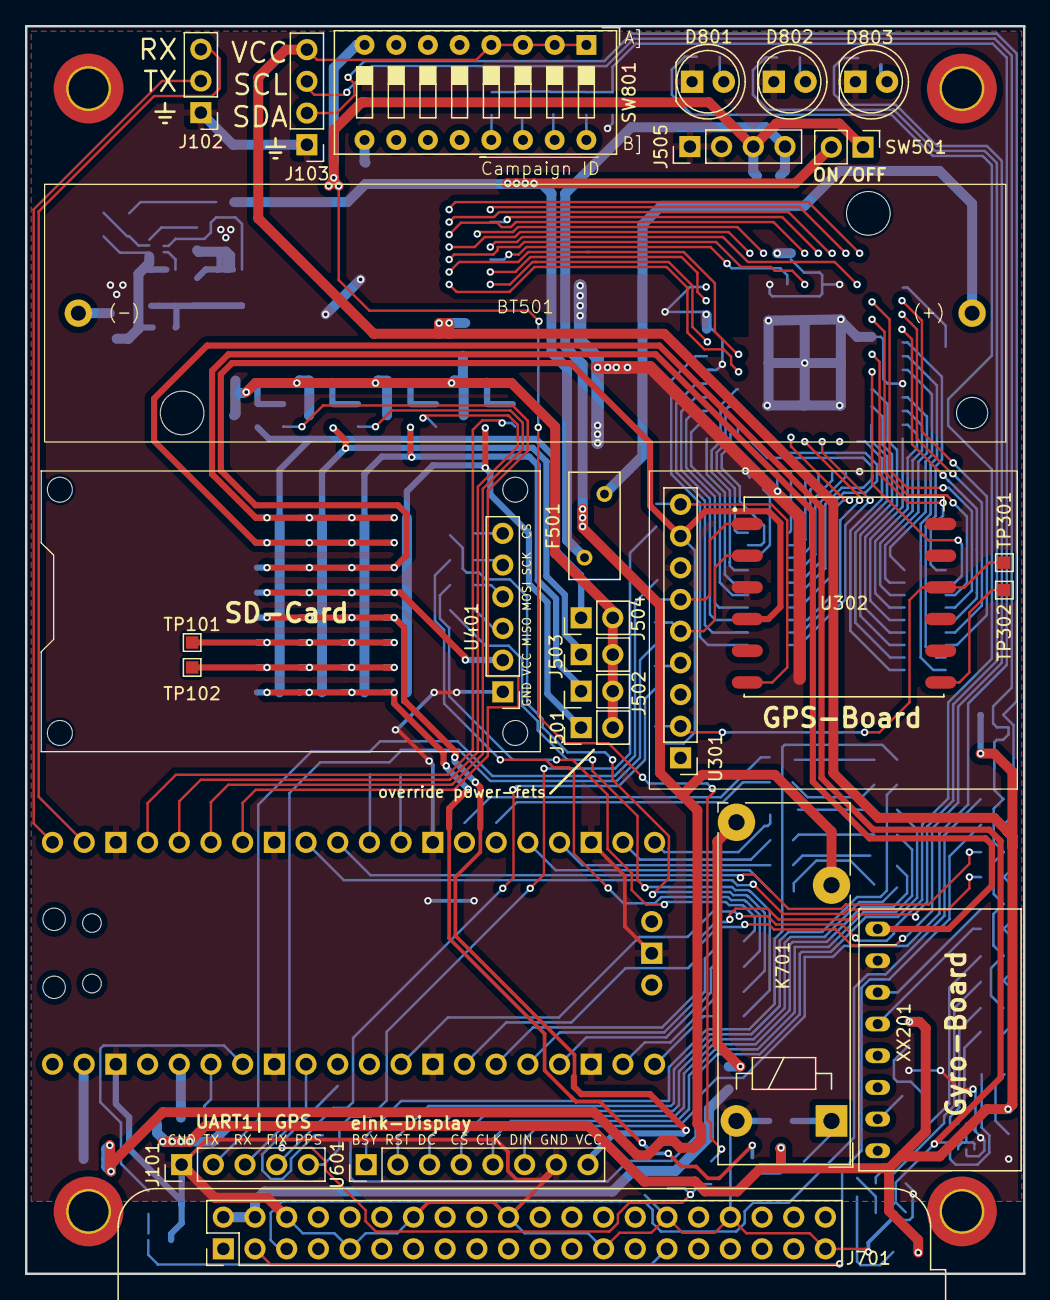
[picture p17: board pouch2.kicad_pcb from above]

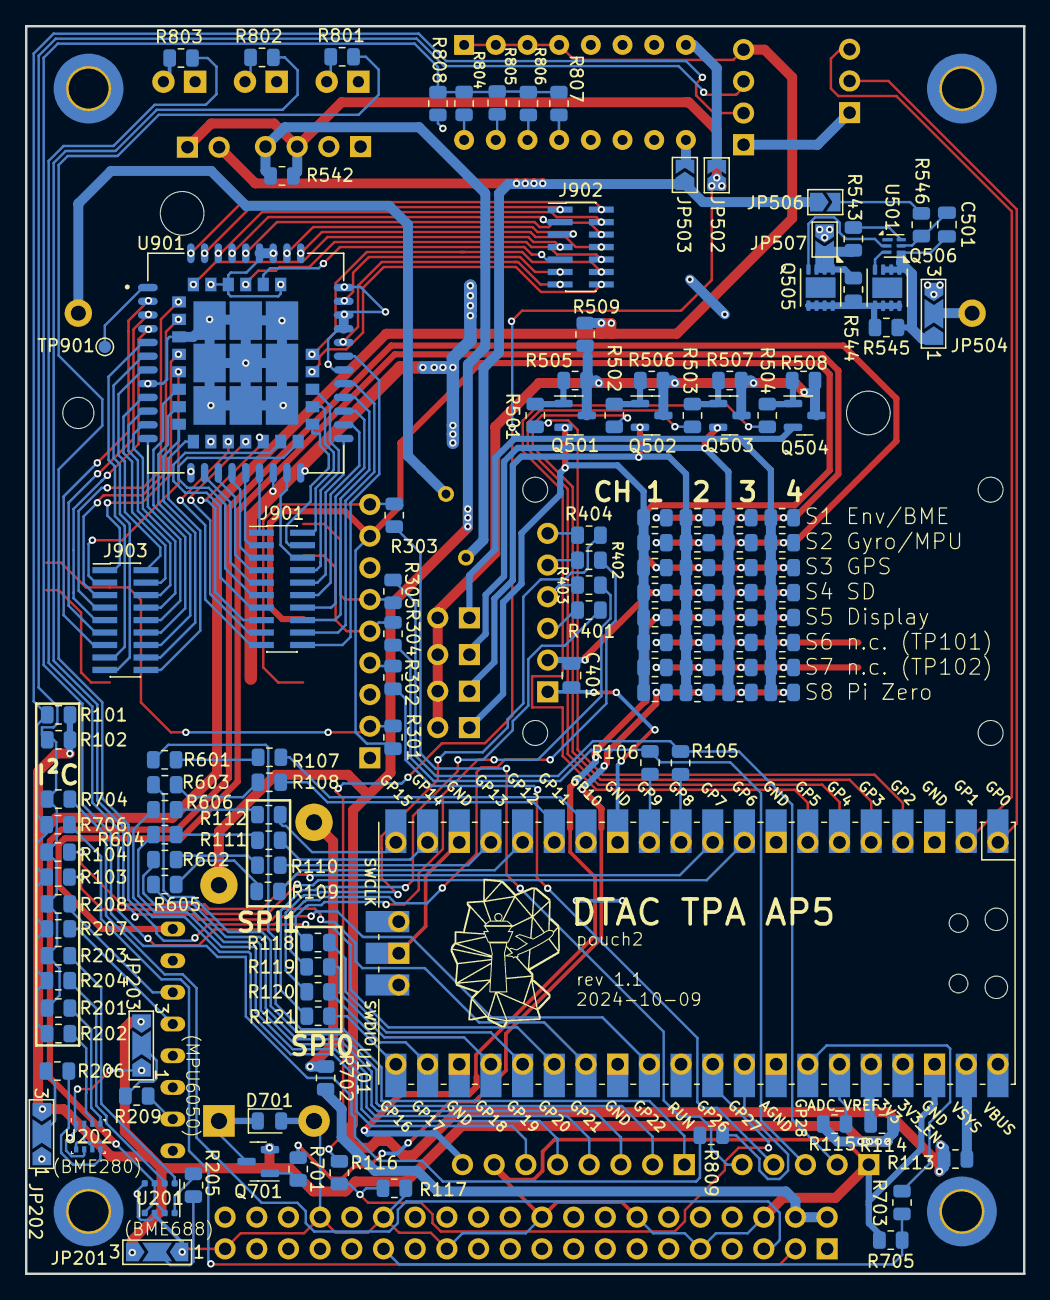
[picture p18: board pouch2.kicad_pcb from below]

Board: 2 copper layers, 80.0 x 100.0 mm, 163 parts (133 on the bottom side), 175 nets.
