movement-recognition/pouch2/(commit log)

2024-08-31 initial setup
    [accel_gyro.kicad_sch, gps.kicad_sch, pouch2.kicad_pcb, pouch2.kicad_sch]
2024-09-01 added power, sdcard
    [accel_gyro.kicad_sch, eink_display.kicad_sch, gps.kicad_sch, hmi.kicad_sch, io_expander.kicad_sch, pouch2.kicad_sch, power.kicad_sch, sd_card.kicad_sch]
2024-09-05 added pi zero header
    [accel_gyro.kicad_sch, gps.kicad_sch, hmi.kicad_sch, pi_zero.kicad_sch, pouch2.kicad_sch, power.kicad_sch]
2024-09-08 started PCB design
    [accel_gyro.kicad_sch, eink_display.kicad_sch, gps.kicad_sch, hmi.kicad_sch, pi_zero.kicad_sch, pouch2.kicad_pcb, pouch2.kicad_sch, power.kicad_sch]
2024-09-08 PCB and footprint arrangements
    [hmi.kicad_sch, pi_zero.kicad_sch, pouch2.kicad_pcb, pouch2.kicad_sch, power.kicad_sch]
2024-09-11 updated backside of PCB
    [accel_gyro.kicad_sch, gps.kicad_sch, hmi.kicad_sch, pouch2.kicad_pcb, power.kicad_sch, sd_card.kicad_sch]
2024-09-12 minor updates
    [pouch2.kicad_pcb, power.kicad_sch]
2024-09-13 added SIM 868 footprints
2024-09-14 added SIM 868 schematic
    [pouch2.kicad_sch, sim868_module.kicad_sch]
2024-09-14 started routing
    [accel_gyro.kicad_sch, eink_display.kicad_sch, gps.kicad_sch, hmi.kicad_sch, pi_zero.kicad_sch, pouch2.kicad_pcb, pouch2.kicad_sch, power.kicad_sch]
2024-09-14 drawed a lot of things
    [accel_gyro.kicad_sch, eink_display.kicad_sch, gps.kicad_sch, hmi.kicad_sch, io_expander.kicad_sch, pi_zero.kicad_sch, pouch2.kicad_pcb, pouch2.kicad_sch]
2024-09-15 finished first routing pass
    [accel_gyro.kicad_sch, eink_display.kicad_sch, gps.kicad_sch, hmi.kicad_sch, io_expander.kicad_sch, pi_zero.kicad_sch, pouch2.kicad_pcb, pouch2.kicad_sch]
2024-09-22 updated power routing
    [gps.kicad_sch, pouch2.kicad_pcb, pouch2.kicad_sch, power.kicad_sch]
2024-09-24 added sim-module breakout
    [pouch2.kicad_pcb, sim868_module.kicad_sch]
2024-10-07 added VCC-battery measurement line
    [accel_gyro.kicad_sch, eink_display.kicad_sch, gps.kicad_sch, hmi.kicad_sch, pi_zero.kicad_sch, pouch2.kicad_pcb, pouch2.kicad_sch, power.kicad_sch]
2024-10-09 moved all holes on pads away
    [pouch2.kicad_pcb]
2024-10-09 rename pouch2 folder into pcb
    [accel_gyro.kicad_sch, eink_display.kicad_sch, gps.kicad_sch, hmi.kicad_sch, io_expander.kicad_sch, pi_zero.kicad_sch, pouch2.csv, pouch2.kicad_pcb]
2024-10-09 removed pouch folder (duplicate)
    [accel_gyro.kicad_sch, eink_display.kicad_sch, gps.kicad_sch, hmi.kicad_sch, io_expander.kicad_sch, pi_zero.kicad_sch, pouch2.csv, pouch2.kicad_pcb]
2024-10-09 chore: cleanup repo
    [pouch2.csv]
2024-10-12 added pico-sdk as submodule
2024-10-12 switched branch
2024-10-29 added initial version of device comparison
    [device_comparison.ods]
2024-10-30 added colors and expanded description texts
    [device_comparison.ods]
2024-10-30 added colors and expanded description texts (II)
    [device_comparison.ods]
2024-10-30 updated i2c-library
2024-11-11 extended specifications
    [device_comparison.ods]
2024-11-12 fixed lockup during I2c read
    [PouchTasker.cpp, PouchTasker.h, main.cpp]
2024-11-13 added timing improvements for IMU, ENV
    [2024-11-11_i2c_acceleration.csv]
2024-11-18 added spi-sdcard-library
2024-11-21 remove no-OS-FatFS-SD-SDIO-SPI-RPi-Pico-package
2024-11-26 fixed missing GND-line to SD-Card-Adapter
    [pouch2.kicad_pcb]
2024-11-26 added capacitor for SD-Card
    [pouch2.kicad_pcb, sd_card.kicad_sch]
2024-11-26 added details on SPI-Failure
    [pouch2.kicad_pcb]
2024-11-27 added queue, fixed SD-Card
    [PouchTasker.cpp, PouchTasker.h, main.cpp]
2024-11-27 added IMU logging
2024-12-01 updated ToDos in PCB design
